pvint/Starfish-PWM-Driver/12V-SmartSwitch-BOM.ods

Source: | /home/pvint/Electronics/12V-SmartSwitch/12V-SmartSwitch.sch
Date: | Wed 20 Feb 2019 06:44:30 PM EST |  |  |  |  |  | Total BOM: | 22.115
Tool: | Eeschema 5.0.1
Generator: | /usr/share/kicad/plugins/bom_csv_grouped_by_value_with_fp.py
Component Count: | 74
Ref | Qnty | Value | Cmp name | Footprint | Description | Vendor | Cost Ea | Ext Cost
C2, C8, C9, C7, C4, | 4 | 0.1u | C | Capacitor_SMD:C_0805_2012Metric | Unpolarized capacitor |  | 0.07 | 0.28
C6, C5, C3, C1, C11, | 5 | 10u | C | Capacitor_SMD:C_0805_2012Metric | Unpolarized capacitor |  | 0.048 | 0.24
C10, | 1 | 47u | CP | Capacitor_SMD:CP_Elec_6.3x5.9 | Polarized capacitor |  | 0.3 | 0.3
D1, | 1 | SP0503BAHT | SP0503BAHT | Package_TO_SOT_SMD:SOT-143 | TVS Diode Array, 5.5V Standoff, 3 Channels, SOT-143 package |  | 1.14 | 1.14
D2, D5, D3, | 3 | LED | LED | LED_SMD:LED_0805_2012Metric | Light emitting diode |  | 0.25 | 0.75
D4, | 1 | 1N5819 | 1N5819 | Diode_SMD:D_SOD-123 | 40V 1A Schottky Barrier Rectifier Diode, DO-41 |  | 0.515 | 0.515
J1, | 1 | Screw_Terminal_01x02 | Screw_Terminal_01x02 | 12V-SmartSwitch:SCREW TERMINAL BLOCK 3.5MM 2POS | Generic screw terminal, single row, 01x02, script generated (kicad-library-utils/schlib/autogen/connector/) |  | 0.4 | 0.4
J2, | 1 | Conn_01x02_Male | Conn_01x02_Male | Connector_PinSocket_2.54mm:PinSocket_1x02_P2.54mm_Vertical | Generic connector, single row, 01x02, script generated (kicad-library-utils/schlib/autogen/connector/) |  | 0.05 | 0.05
J3, | 1 | USB_B_Micro | USB_B_Micro | 12V-SmartSwitch:USB_Micro-B_Amphenol_10118194-0001LF_Horizontal | USB Micro Type B connector |  | 0.5 | 0.5
J4, | 1 | Conn_01x06_Male | Conn_01x06_Male | Connector_PinHeader_2.54mm:PinHeader_1x06_P2.54mm_Vertical | Generic connector, single row, 01x06, script generated (kicad-library-utils/schlib/autogen/connector/) |  | 0 | 0
J5, J7, | 2 | Conn_01x16_Male | Conn_01x16_Male | Connector_PinHeader_2.54mm:PinHeader_1x16_P2.54mm_Vertical | Generic connector, single row, 01x16, script generated (kicad-library-utils/schlib/autogen/connector/) |  | 0.3 | 0.6
J6, | 1 | Conn_01x09_Male | Conn_01x09_Male | Connector_Wago:Wago_734-139_1x09_P3.50mm_Vertical | Generic connector, single row, 01x09, script generated (kicad-library-utils/schlib/autogen/connector/) |  | 1.96 | 1.96
JP1, JP2, | 2 | SolderJumper_2_Bridged | SolderJumper_2_Bridged | Jumper:SolderJumper-2_P1.3mm_Bridged2Bar_Pad1.0x1.5mm | Solder Jumper, 2-pole, closed/bridged |  |  | 0
Q2, Q1, Q6, Q5, Q10, Q9, Q15, Q14, | 8 | DMG2305UX | IRLML6402 | Package_TO_SOT_SMD:SOT-23 | -3.7A Id, -20V Vds, P-channel MOSFET, 65mOhm Rds, SOT-23 |  | 0.53 | 4.24
Q13, Q16, Q4, Q3, Q8, Q7, Q12, Q11, Q18, Q17, | 10 | MMBT2222A | BC817 | Package_TO_SOT_SMD:SOT-23 | 0.8A Ic, 45V Vce, NPN Transistor, SOT-23 |  | 0.076 | 0.76
R1, R2, R3, R8, R9, R14, R15, R21, R22, | 2 | 1k | R | Resistor_SMD:R_0805_2012Metric | Resistor |  | 0.01 | 0.02
R6, | 1 | 22.1k | R | Resistor_SMD:R_0805_2012Metric | Resistor |  | 0.01 | 0.01
R7, | 1 | 47.5k | R | Resistor_SMD:R_0805_2012Metric | Resistor |  | 0.01 | 0.01
R12, R18, R13, | 3 | 2.2k | R | Resistor_SMD:R_0805_2012Metric | Resistor |  | 0.01 | 0.03
R5, R20, R23, R19, R4, R11, R10, R17, R16, R25, R24, R26, | 19 | 10k | R | Resistor_SMD:R_0805_2012Metric | Resistor |  | 0.01 | 0.19
SW1, SW2, | 2 | SW_Push | SW_Push | 12V-SmartSwitch:SW_TACTILE_PO21301 | Push button switch, generic, two pins |  | 0.42 | 0.84
U1, | 1 | CP2102N-A01-GQFN24 | CP2102N-A01-GQFN24 | Package_DFN_QFN:QFN-24-1EP_4x4mm_P0.5mm_EP2.6x2.6mm | USB to UART master bridge |  | 2.04 | 2.04
U2, | 1 | ESP32-WROOM-32 | ESP32-WROOM-32 | 12V-SmartSwitch:ESP32-WROOM-32-Espressif-Symbol-Kicad-62379 |  |  | 6.79 | 6.79
U3, | 1 | AP1117-33 | AP1117-33 | Package_TO_SOT_SMD:SOT-223-3_TabPin2 | 1A Low Dropout regulator, positive, 3.3V fixed output, SOT-223 |  | 0.45 | 0.45
 |  |  |  |  |  |  |  | 0
 |  |  |  |  |  |  |  | 0
