pvint/Starfish-PWM-Driver/(threads)

Thread 12 (2020-08-05):

LED D7 glowing slightly by default

pvint, 2020-08-05:
LED D7 is on GPIO5, and it is glowing slightly by default. The default for the GPIO after rester has a weak pullup (See page 60, IO_MUX section, in the ESP32 datasheet)

Add a weak pull-down to that GPIO (maybe 20k? Also, check if we can use a weaker pulldown on the other GPIOs that already have a pulldown resistor installed)

Closed 2020-08-15.

Thread 17 (2020-08-14):

BJTs in driver circuit dissipating too much heat

pvint, 2020-08-14:
I think the base current is way too low....

Off the top of my head calcs:
3.3V - 0.6V through the 10k: (3.3-6)/10^3 = 270 uA
Typical gain is ~50, thus max CE current: 270uA * 50 = 13.5mA

1k from Vdc to collector (assuming CE shorted) at 13.5V gives, you guessed it, 13.5mA

I think we're running in the active region! Ooops

Closed 2020-08-15.

Thread 18 (2020-08-15):

USB connector and buttons too far inside enclosure

pvint, 2020-08-15:
Extend board 2mm - should put the connector flush to inside of housing (don't want it protruding for the time being to allow option to have that end of the enclosure closed)
