pvint/Starfish-PWM-Driver/(commit log)

2020-03-21 RevA - before RevB changes
    [12V-SmartSwitch-BOM.ods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]
2020-03-21 Move top edges of PCB down - fixes #8
    [12V-SmartSwitch.kicad_pcb, 12V-SmartSwitch.sch]
2020-03-21 Moved connectors and silk out at bottom (will fix routing after other routing changes) - Fixes #7
    [12V-SmartSwitch.kicad_pcb]
2020-06-11 RevC updates
    [12V-SmartSwitch.kicad_pcb, 12V-SmartSwitch.sch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]
2020-07-29 Fixed silk designators R31/32 (Fixes #11)
    [12V-SmartSwitch.kicad_pcb]
2020-07-29 Fixed silk designators for I2C header
    [12V-SmartSwitch.kicad_pcb, 12V-SmartSwitch.sch]
2020-08-01 Removed misleading "+" on Vin silk
    [12V-SmartSwitch.kicad_pcb]
2020-08-04 Removed feedback resistors on regulator (not needed for TPS560430X3 part!) - need to revisit routing an placement
    [12V-SmartSwitch.kicad_pcb, 12V-SmartSwitch.sch]
2020-08-05 Finished PS layout (plus a few little touchups)
    [12V-SmartSwitch.kicad_pcb]
2020-08-05 Changed silk to reflect RevD
    [12V-SmartSwitch.kicad_pcb]
2020-08-05 Changed MOSFETs to SSMJ (Fixes #5)
    [12V-SmartSwitch.sch]
2020-08-15 Extended PCB out by main connector for silscreen (Fixes #16)
    [12V-SmartSwitch.kicad_pcb]
2020-08-15 Added silk reference for GPIO LEDs (Fixes #15)
    [12V-SmartSwitch.kicad_pcb]
2020-08-15 Added pulldown on GPIO5 (Fixes #12)
    [12V-SmartSwitch.kicad_pcb]
2020-08-15 Fix LED colours and adjusted current limiting resistors
    [12V-SmartSwitch.kicad_pcb, 12V-SmartSwitch.sch]
2020-08-15 Lowered base resistance on BJTs (Fixes #17)
    [12V-SmartSwitch.kicad_pcb, 12V-SmartSwitch.sch]
2020-08-28 Added reverse polarity protection
    [12V-SmartSwitch.kicad_pcb, 12V-SmartSwitch.sch]
2020-09-25 Added reverse voltage protection
    [12V-SmartSwitch.kicad_pcb, 12V-SmartSwitch.sch]
